CGainsWorks/emb-drone-flight-stack/hardware/flight-controller/outputs/bom/FCSTMV1.05-10.19.csv

Id | Designator | Footprint | Quantity | Designation | Supplier and ref
1 | J327,J376,J94,J308 | PinSocket_1x04_P2.54mm_Vertical | 4 | LED
2 | J323,J349,J403,J160,J342,J21,J150,J101,J12,J237,J269,J223,J367,J180,J25,J106,J263,J26,J381,J266,J174,J257,J314,J225,J3,J139,J326,J68,J324,J400,J14,J300,J176,J7,J255,J105,J243,J8,J201,J274,J186,J230,J224,J214,J347,J397,J188,J198,J15,J9,J154,J231,J111,J387,J153,J50,J187,J227,J241,J64,J185,J279,J220,J304,J303,J271,J70,J268,J194,J384,J200,J396,J287,J90,J368,J338,J260,J401,J244,J193,J77,J182,J27,J371,J96,J399,J358,J1,J305,J280,J407,J219,J217,J46,J259,J319,J147,J45,J295,J351,J317,J245,J28,J286,J377,J4,J183,J306,J181,J379,J242,J216,J146,J354,J143,J270,J328,J302,J61,J20,J49,J10,J199,J334,J141,J256,J318,J402,J123,J374,J209,J252,J212,J340,J51,J316,J385,J226,J285,J299,J100,J69,J79,J213,J404,J11,J73,J273,J85,J228,J177,J53,J267,J57,J262,J386,J32,J284,J236,J298,J309,J394,J184,J405,J86,J151,J54,J75,J159,J76,J83 | PinSocket_1x01_P2.54mm_Vertical | 171 | Conn_01x01_Pin
3 | J239,J251,J17,J232,J233,J282,J42,J294,J16,J189,J196,J208,J276,J275,J190,J23 | PinHeader_1x02_P2.54mm_Vertical | 16 | Conn_01x02_Pin
4 | R272,R299,R279,R34,R293,R245,R33,R298,R37,R283,R260,R40,R265,R270,R32,R39,R295,R266,R99,R280,R38,R247,R31,R93,R267,R276,R273,R244,R290,R63,R126,R128,R131,R119,R62,R112,R127,R121 | R_1206_3216Metric_Pad1.30x1.75mm_HandSolder | 38 | 0 ohm, 1206
5 | J393,J357,J331,J366,J31,J157,J155,J30,J156,J56,J112,J272,J59,J158,J80,J390,J313,J395,J135,J55,J246,J361,J203,J204,J332,J312,J365,J389,J110,J36,J356,J35,J128,J229,J149,J165,J173,J144,J152,J163,J172,J78 | PinSocket_1x02_P2.54mm_Vertical | 42 | Conn_01x02_Pin
6 | J248,J131,J211,J277,J215,J322,J19,J142,J87,J48,J47,J253,J234,J398,J336,J39,J372,J291,J192,J191,J210,J88,J297,J89,J383,J301,J337,J52,J409,J258,J254,J124,J345,J74,J166,J296,J205,J278,J18,J58,J235,J164,J130,J81 | PinSocket_1x03_P2.54mm_Vertical | 44 | Conn_01x03_Pin
7 | IC15,IC12 | QFP50P900X900X120-48N | 2 | ATMEGA4809-AF
8 | L16 | L_0603_1608Metric_Pad1.05x0.95mm_HandSolder | 1 | 22nH, 0603
9 | R294,R222,R221,R87,R90,R220,R81,R223,R88,R89 | R_1206_3216Metric_Pad1.30x1.75mm_HandSolder | 10 | 100 ohm, 1206
10 | C168,C171,C192,C210,C22,C193,C176,C19,C16,C172,C317,C197,C235,C189,C218,C10,C14,C213,C214,C13,C222,C244,C25,C9,C188,C35,C167,C66,C53,C50,C209,C39 | C_1206_3216Metric_Pad1.33x1.80mm_HandSolder | 32 | 100nF, 1206
11 | C256,C322,C131,C281,C114,C103,C113,C126,C135,C254,C133,C134,C253,C236,C266,C230,C132,C274,C237,C259,C277,C124,C128,C115,C112,C262,C224,C129,C267,C238,C280,C122,C261,C119,C271,C275,C226,C123,C273,C102,C278,C265,C120,C116,C227,C125,C231,C130,C228,C239,C225,C154,C156,C75,C152,C138,C144,C72,C155,C73,C136 | C_1206_3216Metric_Pad1.33x1.80mm_HandSolder | 61 | 0.1uF, 1206
12 | U10,U12,U11,U1 | LQFP-48_7x7mm_P0.5mm | 4 | STM32F051C8Tx
13 | R172,R26,R157,R13,R16,R209,R201,R146,R180,R175,R159,R183,R211,R24,R149,R198,R206,R208,R154,R23,R21,R185,R182,R156,R54 | R_1206_3216Metric_Pad1.30x1.75mm_HandSolder | 25 | 10k Ohm, 50V, 1206
14 | C283,C282 | C_1206_3216Metric_Pad1.33x1.80mm_HandSolder | 2 | 33 pF, 1206
15 | C279,C272,C223,C106,C303,C81,C263,C298,C276,C305,C229 | C_1206_3216Metric_Pad1.33x1.80mm_HandSolder | 11 | 4.7uF, 1206
16 | R147,R181,R22,R25,R184,R158,R173,R210,R207,R155,R14,R199 | R_1206_3216Metric_Pad1.30x1.75mm_HandSolder | 12 | 1k Ohm, 50V, 1206
17 | J24,J129,J333,J127,J341,J283,J350,J102,J364,J136,J335,J240,J197,J145,J137 | PinSocket_1x04_P2.54mm_Vertical | 15 | Conn_01x04_Pin
18 | INLA4,INLA3,INLA2,INLA1 | DRV8300DRGER- VQFN-24_L4.0-W4.0-P0.50-BL-EP2.5 | 4 | DRV8300DRGER
19 | C295,C284,C257,C302,C296,C319,C307,C293,C297,C268,C270 | C_1206_3216Metric_Pad1.33x1.80mm_HandSolder | 11 | 1 uF, 1206
20 | J307,J22,J388,J292,J249,J40,J238,J206,J348,J310,J378,J339,J195,J116,J281,J375 | PinSocket_1x05_P2.54mm_Vertical | 16 | Conn_01x05_Pin
21 | C198,C179,C178,C220,C200,C177,C26,C199,C28,C23,C221,C219 | C_1206_3216Metric_Pad1.33x1.80mm_HandSolder | 12 | 1uF, 50V, 1206
22 | R262,R243,R256,R254,R236,R261,R219,R289,R264,R218,R255,R216,R217,R257,R242,R274,R259,R288,R263 | R_1206_3216Metric_Pad1.30x1.75mm_HandSolder | 19 | 1k ohm, 1206
23 | J363,J118 | PinSocket_1x09_P2.54mm_Vertical | 2 | Conn_01x09_Pin
24 | C82 | C_1206_3216Metric_Pad1.33x1.80mm_HandSolder | 1 | 6.2pF, 1206
25 | D18,D6 | LED_0603_1608Metric_Pad1.05x0.95mm_HandSolder | 2 | APT1608QBC/G
26 | R98 | R_1206_3216Metric_Pad1.30x1.75mm_HandSolder | 1 | 27 ohm, 1206
27 | J132,J121,J133 | PinHeader_1x08_P2.54mm_Vertical | 3 | Conn_01x08_Pin
28 | R148,R200,R27,R249,R174,R250,R212,R15,R106,R167,R10,R143,R169,R105,R193,R141,R61,R195,R116,R8,R58 | R_1206_3216Metric_Pad1.30x1.75mm_HandSolder | 21 | 10k Ohm, 1206
29 | R101,R102 | R_1206_3216Metric_Pad1.30x1.75mm_HandSolder | 2 | 2 ohm, 1206
30 | R237,R239,R95,R240,R238,R97,R82 | R_1206_3216Metric_Pad1.30x1.75mm_HandSolder | 7 | 100k ohm, 1206
31 | J72,J344,J329,J119,J120,J97,J289,J29,J34,J107,J38,J360,J290,J392,J67,J247,J353,J391,J222,J66,J2,J63,J65,J162,J6,J134,J5,J218,J161,J352,J178,J95,J179,J60,J103,J91,J261,J355,J13,J104,J265,J369,J140,J175,J221,J264,J62 | SolderWirePad_1x01_SMD_5x10mm | 47 | Conn_01x01_Pin
32 | C95 | C_1206_3216Metric_Pad1.33x1.80mm_HandSolder | 1 | KGF31AR73A103KU
33 | R120,R122,R111 | R_1206_3216Metric_Pad1.30x1.75mm_HandSolder | 3 | RNCE1206BTE1K00
34 | C250,C258 | C_1206_3216Metric_Pad1.33x1.80mm_HandSolder | 2 | 22nF, 1206
35 | C195,C216,C232,C287,C174,C17,C233,C29,C31 | C_1206_3216Metric_Pad1.33x1.80mm_HandSolder | 9 | 10nF, 1206
36 | J408 | AMASS_XT30PW-M | 1 | XT30PW-M
37 | SW2,SW1 | SW-TH_RKJXK1210002 | 2 | RKJXK1210002
38 | C97,C90,C99,C91 | C_1206_3216Metric_Pad1.33x1.80mm_HandSolder | 4 | KGM31HR71E105KU
39 | R278,R68,R75 | R_1206_3216Metric_Pad1.30x1.75mm_HandSolder | 3 | 75 ohm, 1206
40 | Q31,Q32,Q30,Q34,Q35 | INFINEON_SOT343 | 5 | BFP520H6327XTSA1
41 | R92,R91 | R_1206_3216Metric_Pad1.30x1.75mm_HandSolder | 2 | 4.7k ohm, 1206
42 | J359,J202,J293,J33,J41,J315,J346,J250,J126,J207 | PinSocket_1x06_P2.54mm_Vertical | 10 | Conn_01x06_Pin
43 | R203,R151,R20,R179,R177,R18,R205,R153 | R_1206_3216Metric_Pad1.30x1.75mm_HandSolder | 8 | 0 Ohm, 1206
44 | R271,R277 | R_1206_3216Metric_Pad1.30x1.75mm_HandSolder | 2 | 200 ohm, 1206
45 | J311,J43,J37,J92,J320,J167,J330,J343,J168,J171,J169,J170 | SolderWirePad_1x01_SMD_1x2mm | 12 | Conn_01x01_Pin
46 | FL4 | BFCN5750 | 1 | BFCN-5750+
47 | R28,R30,R109,R74,R113 | R_1206_3216Metric_Pad1.30x1.75mm_HandSolder | 5 | 5.1k Ohm, 1206
48 | C110,C105,C108 | C_1206_3216Metric_Pad1.33x1.80mm_HandSolder | 3 | 220pF, 1206
49 | R292 | R_1206_3216Metric_Pad1.30x1.75mm_HandSolder | 1 | 10 ohm, 1206
50 | C169,C211,C111,C101,C306,C285,C286,C299,C288,C11,C190,C321 | C_1206_3216Metric_Pad1.33x1.80mm_HandSolder | 12 | 100pF, 1206
51 | R145,R12,R171,R197 | R_1206_3216Metric_Pad1.30x1.75mm_HandSolder | 4 | 1k Ohm, 1206
52 | C310,C294,C304,C300,C292 | C_1206_3216Metric_Pad1.33x1.80mm_HandSolder | 5 | 6pF, 1206
53 | J321,J117,J125,J362,J113,J114,J382,J325,J122,J84,J82 | PinSocket_1x07_P2.54mm_Vertical | 11 | Conn_01x07_Pin
54 | R17,R176,R202,R150,R55,R35,R231,R50,R56,R232,R48,R29 | R_1206_3216Metric_Pad1.30x1.75mm_HandSolder | 12 | 100k Ohm, 1206
55 | Y5,Y2,Y1 | FY0800027 | 3 | FY0800027
56 | R226,R227,R251,R96,R94,R225,R213,R224,R248 | R_1206_3216Metric_Pad1.30x1.75mm_HandSolder | 9 | 10k ohm, 1206
57 | C117,C127,C87,C89,C243,C65,C76,C158,C52,C141,C88,C153,C40,C24,C51 | C_1206_3216Metric_Pad1.33x1.80mm_HandSolder | 15 | 1uF, 1206
58 | R284,R67,R65,R66 | R_1206_3216Metric_Pad1.30x1.75mm_HandSolder | 4 | 22 ohm, 1206
59 | D1 | SMF5V0AE308 | 1 | SMF5V0A-E3-08
60 | D16,D15,D2,D17,D11,D12,D13,D10,D9,D14,D3,D4 | D_SOD-323F | 12 | PMEG4010CEJ,115
61 | C92 | C_1206_3216Metric_Pad1.33x1.80mm_HandSolder | 1 | KAF31ER71H474KL
62 | R125,R123 | R_1206_3216Metric_Pad1.30x1.75mm_HandSolder | 2 | TNPW120675R0BEEA
63 | R269 | R_1206_3216Metric_Pad1.30x1.75mm_HandSolder | 1 | 2.2k ohm, 1206
64 | C215,C191,C104,C194,C308,C196,C15,C21,C173,C313,C170,C107,C12,C217,C175,C212,C86,C157 | C_1206_3216Metric_Pad1.33x1.80mm_HandSolder | 18 | 10uF, 1206
65 | R234 | R_1206_3216Metric_Pad1.30x1.75mm_HandSolder | 1 | 18 ohm, 1206
66 | C264,C84,C260 | C_1206_3216Metric_Pad1.33x1.80mm_HandSolder | 3 | 20pF, 1206
67 | R258 | R_1206_3216Metric_Pad1.30x1.75mm_HandSolder | 1 | 12k ohm, 1206
68 | R11,R196,R170,R228,R144,R168,R194,R60,R142,R52,R9 | R_1206_3216Metric_Pad1.30x1.75mm_HandSolder | 11 | 100 Ohm, 1206
69 | Q8,Q9 | SOT-323_SC-70_Handsoldering | 2 | bc817w
70 | R296 | R_1206_3216Metric_Pad1.30x1.75mm_HandSolder | 1 | 200k ohm, 1206
71 | PS5 | SOT65P210X110-5N | 1 | TPS61169DCKR
72 | C289,C290 | C_1206_3216Metric_Pad1.33x1.80mm_HandSolder | 2 | 6.8pF, 1206
73 | R72 | R_1206_3216Metric_Pad1.30x1.75mm_HandSolder | 1 | 510k ohm, 1206
74 | C80,C312 | C_1206_3216Metric_Pad1.33x1.80mm_HandSolder | 2 | 33pF, 1206
75 | R103,R104,R132,R133 | R_1206_3216Metric_Pad1.30x1.75mm_HandSolder | 4 | 2.7k Ohms, 1206
76 | R86 | R_1206_3216Metric_Pad1.30x1.75mm_HandSolder | 1 | CRT1206-FX-4702ELF
77 | L15 | L_0603_1608Metric_Pad1.05x0.95mm_HandSolder | 1 | 10nH, 0603
78 | J373 | PinSocket_1x30_P2.54mm_Vertical | 1 | Conn_01x30_Pin
79 | C139,C145,C146,C143,C149,C151,C140,C137,C78,C77 | C_1206_3216Metric_Pad1.33x1.80mm_HandSolder | 10 | KAF31BR71H104KT
80 | C315,C323 | C_1206_3216Metric_Pad1.33x1.80mm_HandSolder | 2 | X F, 1206
81 | U13,U3 | FW520WFMT1 - SMD-4_L2.0-W1.6-FW520WFMT1 | 2 | FW520WFMT1
82 | R229 | R_1206_3216Metric_Pad1.30x1.75mm_HandSolder | 1 | 27k Ohm, 25V, 1206
83 | J99,J93,J108,J98,J148 | PinSocket_1x01_P2.00mm_Vertical | 5 | Conn_01x01_Pin
84 | Q33 | SOT96P237X111-3N | 1 | MMBTH81
85 | Q29,Q7,Q28 | SOT95P237X112-3N | 3 | IRLML0030TRPBF
86 | J109,J406 | U.FL-R-SMT-1_10_ | 2 | U.FL-R-SMT-1_10_
87 | IC1 | DQA_R-PUSON-N10_ | 1 | TPD4EUSB30DQAR
88 | D8,D20 | LED_0603_1608Metric_Pad1.05x0.95mm_HandSolder | 2 | APT1608SECK
89 | L13 | L_0603_1608Metric_Pad1.05x0.95mm_HandSolder | 1 | 33nH, 0603
90 | C251 | C_1206_3216Metric_Pad1.33x1.80mm_HandSolder | 1 | X uF, 1206
91 | R241 | R_1206_3216Metric_Pad1.30x1.75mm_HandSolder | 1 | 10.2 ohm, 1206
92 | C311,C316,C328,C100,C109,C41,C54 | C_1206_3216Metric_Pad1.33x1.80mm_HandSolder | 7 | 10pF, 1206
93 | C234,C33 | C_1206_3216Metric_Pad1.33x1.80mm_HandSolder | 2 | KAF31ER71H474KU
94 | R178,R204,R152,R19 | R_1206_3216Metric_Pad1.30x1.75mm_HandSolder | 4 | 0 Ohm, 12060 Ohm, 1206
95 | U14 | TQFP-64_7x7mm_P0.4mm | 1 | ~
96 | U2 | ESP32C3MINI1H4X | 1 | ESP32-C3-MINI-1-H4X
97 | C93,C96 | C_1206_3216Metric_Pad1.33x1.80mm_HandSolder | 2 | 15pF, 1206
98 | IC11 | ESP32WROOM32EH4 | 1 | ESP32-WROOM-32E-H4
99 | J288,J370 | PinSocket_1x12_P2.54mm_Vertical | 2 | Conn_01x12_Pin
100 | J44,J138 | USB4730GFAKIT | 2 | USB4730-GF-A-KIT
101 | FL1 | 0805USBN121MRC | 1 | 0805USBN-271MRC
102 | R83 | R_1206_3216Metric_Pad1.30x1.75mm_HandSolder | 1 | 3.3k Ohm, 1206
103 | R69,R71,R285 | R_1206_3216Metric_Pad1.30x1.75mm_HandSolder | 3 | 1.2k ohm, 1206
104 | S4,S5,S2,S3,S1 | PTS647SK70SMTR2NLFS | 5 | PTS647SK70SMTR2N_LFS
105 | R246 | R_1206_3216Metric_Pad1.30x1.75mm_HandSolder | 1 | 1M ohm, 1206
106 | C118,C121,C147,C85 | C_1206_3216Metric_Pad1.33x1.80mm_HandSolder | 4 | 2.2uF, 1206
107 | R230 | R_1206_3216Metric_Pad1.30x1.75mm_HandSolder | 1 | 10k Ohm, 25V, 1206
108 | LS2,LS1 | CMT8504100SMTTR | 2 | CMT-8504-100-SMT-TR
109 | C252 | C_1206_3216Metric_Pad1.33x1.80mm_HandSolder | 1 | 4.7 uF, 1206
110 | R268 | R_1206_3216Metric_Pad1.30x1.75mm_HandSolder | 1 | 390k ohm, 1206
111 | U17 | TA0555A | 1 | ~
112 | ANT2 | SAMM10Q00B | 1 | SAM-M10Q-00B
113 | U16 | RTC6715 - TQFN-48_L7.0-W7.0-P0.50-BL-EP5.5 | 1 | RTC6715
114 | L17 | L_0603_1608Metric_Pad1.05x0.95mm_HandSolder | 1 | 27nH, 0603
115 | Y3,Y4 | ABM810000MHZ12D2W | 2 | ABM8-27.000MHZ-B2-T
116 | R291,R282,R287,R281 | R_1206_3216Metric_Pad1.30x1.75mm_HandSolder | 4 | X ohm, 1206
117 | R84 | R_1206_3216Metric_Pad1.30x1.75mm_HandSolder | 1 | RT1206BRB07100KL
118 | L20,L19 | L_0603_1608Metric_Pad1.05x0.95mm_HandSolder | 2 | 12nH, 0603
119 | IC6 | QPA9501TR13 | 1 | QPA9501TR13
120 | C150,C148 | C_1206_3216Metric_Pad1.33x1.80mm_HandSolder | 2 | CAA572X7R1H476M670LJ
121 | D22 | DIOM5127X229N | 1 | SS16-E3_61T
122 | R100 | R_1206_3216Metric_Pad1.30x1.75mm_HandSolder | 1 | 27.4k ohm, 1206
123 | R297 | R_1206_3216Metric_Pad1.30x1.75mm_HandSolder | 1 | 33k ohm, 1206
124 | R73 | R_1206_3216Metric_Pad1.30x1.75mm_HandSolder | 1 | 560k ohm, 1206
125 | L14 | SRN2010BTA180M | 1 | SRN2010BTA-180M
126 | U15,U6 | SOIC127P790X216-8N | 2 | W25Q128JVSIQ
127 | R42,R41,R117,R118 | R_1206_3216Metric_Pad1.30x1.75mm_HandSolder | 4 | 22 Ohm, 1206
128 | R76 | R_1206_3216Metric_Pad1.30x1.75mm_HandSolder | 1 | 15k Ohm, 1206
129 | C291,C142 | C_1206_3216Metric_Pad1.33x1.80mm_HandSolder | 2 | 0.01uF, 1206
130 | R252,R215,R253,R214 | R_1206_3216Metric_Pad1.30x1.75mm_HandSolder | 4 | 2.7k ohm, 1206
131 | U9 | NINA-B416-01B - LGA-60_L15.0-W10.0-NINA-B406-00B | 1 | NINA-B416-01B
132 | C329,C325 | C_1206_3216Metric_Pad1.33x1.80mm_HandSolder | 2 | 1nF, 1206
133 | U5 | LQFP-144_20x20mm_P0.5mm | 1 | STM32F405ZGTx
134 | R85 | R_1206_3216Metric_Pad1.30x1.75mm_HandSolder | 1 | ERA-8AEB510V
135 | IC16 | SON50P150X150X50-7N-D | 1 | SKY65404-31
136 | U4 | RTC6705 - VFQFN-40_L6.0-W6.0-P0.50-TL-EP4.7-1 | 1 | RTC6705
137 | L12 | LSEUC2520KKT4R7M | 1 | LSEUC2520KKT4R7M
138 | J115 | PinSocket_1x11_P2.54mm_Vertical | 1 | Conn_01x11_Pin
139 | C242,C64 | C_1206_3216Metric_Pad1.33x1.80mm_HandSolder | 2 | 0.01uF, Min. 50V, 1206
140 | C326 | C_1206_3216Metric_Pad1.33x1.80mm_HandSolder | 1 | 1n F, 1206
141 | C327 | C_1206_3216Metric_Pad1.33x1.80mm_HandSolder | 1 | 4.7pF, 1206
142 | BZ1 | Buzzer_12x9.5RM7.6 | 1 | Haptics
143 | C269 | C_1206_3216Metric_Pad1.33x1.80mm_HandSolder | 1 | 22pF, 1206
144 | C309,C301 | C_1206_3216Metric_Pad1.33x1.80mm_HandSolder | 2 | 470pF, 1206
145 | J71 | AMASS_XT60-M | 1 | XT60-M
146 | C314 | C_1206_3216Metric_Pad1.33x1.80mm_HandSolder | 1 | 47pF, 1206
147 | R70 | R_1206_3216Metric_Pad1.30x1.75mm_HandSolder | 1 | 270 ohm, 1206
148 | C98,C94,C79 | C_1206_3216Metric_Pad1.33x1.80mm_HandSolder | 3 | CL31Y475KCK6NWE
149 | IC13,IC2 | QFN50P400X400X100-25N-D | 2 | SX1280IMLTRT
150 | C255,C46,C37,C47,C38,C36,C45 | C_1206_3216Metric_Pad1.33x1.80mm_HandSolder | 7 | 4.7uF, 50V, 1206
151 | C318 | C_1206_3216Metric_Pad1.33x1.80mm_HandSolder | 1 | 12pF, 1206
152 | L18 | SRN5040TAR60MP | 1 | SRN5040TA-R60MP
153 | C324 | C_1812_4532Metric_Pad1.57x3.40mm_HandSolder | 1 | 18125C484KAT2A
154 | R275 | R_1206_3216Metric_Pad1.30x1.75mm_HandSolder | 1 | 430k ohm, 1206
155 | D7,D19 | LED_0603_1608Metric_Pad1.05x0.95mm_HandSolder | 2 | APT1608ZGC
156 | U8 | TSSOP-28_L9.7-W4.4-P0.65-LS6.4-BL-EP-2 | 1 | AT7456E
157 | ANT3,ANT1 | 479480001 | 2 | 47948-0001
158 | R235 | R_1206_3216Metric_Pad1.30x1.75mm_HandSolder | 1 | 56 ohm, 1206
159 | C320 | C_1206_3216Metric_Pad1.33x1.80mm_HandSolder | 1 | 39pF, 1206
160 | R286,R78 | R_1206_3216Metric_Pad1.30x1.75mm_HandSolder | 2 | 470 ohm, 1206
161 | FL3,FL2 | 2450FM07D0034001T | 2 | 2450FM07D0034001T
162 | Q17,Q23,Q13,Q16,Q18,Q19,Q15,Q27,Q12,Q26,Q22,Q3,Q10,Q21,Q25,Q20,Q1,Q6,Q14,Q4,Q2,Q5,Q11,Q24 | BUK7Y1255B115 | 24 | PSMN1R4-40YLDX
163 | R110,R124,R129,R108 | R_1206_3216Metric_Pad1.30x1.75mm_HandSolder | 4 | 4.7k Ohm, 1206
164 | C164,C2,C186,C184,C161,C165,C7,C162,C203,C163,C5,C201,C159,C160,C3,C183,C202,C205,C206,C180,C182,C185,C207,C204,C4,C181,C6,C1 | CAPC6050X690N | 28 | 47uF, 50V, 2420
165 | R134,R3,R166,R140,R186,R192,R139,R161,R136,R6,R164,R138,R190,R5,R2,R191,R7,R1,R162,R135,R160,R165,R187,R188 | R_1206_3216Metric_Pad1.30x1.75mm_HandSolder | 24 | 20 Ohm, 50V, 1206
166 | L2,L5 | L_1206_3216Metric_Pad1.42x1.75mm_HandSolder | 2 | BLM31SN500SH1L
167 | IC4,IC3 | QFN50P300X600X80-29N-D | 2 | LT8612IUDE#PBF
168 | C60,C44 | CAPPRD500W65D1000H2200 | 2 | 25V, 820uF, Low ESR, Through Hole
169 | D5,D21 | DIOM7959X262N | 2 | SMCJ33A
170 | L1,L11,L9 | XAL7030682MEC | 3 | XAL7030-682MEC
171 | L7,L6,L3,L4 | XAL7070472MEC | 4 | XAL7070-472MEC
172 | R4,R137,R163,R189 | R_2512_6332Metric_Pad1.40x3.35mm_HandSolder | 4 | 0.005Ohms, 2512, 5W, Current Sense
173 | C63,C49,C241,C20 | C_1206_3216Metric_Pad1.33x1.80mm_HandSolder | 4 | 220nF, 50V, 1206
174 | IC14 | SOT95P280X100-5N | 1 | ADPL40502AUJZ-1.2-R7
175 | C68,C247 | CAPPRD500W60D1250H2000 | 2 | 35V, 1000uF, Low ESR, Through Hole
176 | C74 | C_1206_3216Metric_Pad1.33x1.80mm_HandSolder | 1 | 560pF, 1206
177 | IC5 | QFN50P500X500X60-33N-D | 1 | STM32G431KBU6
178 | PS2,PS3,PS4,PS1 | SOIC127P600X170-9N | 4 | LMR33630ADDA
179 | C69,C32,C61,C71,C246,C27,C249,C67,C59,C30,C70,C248,C34,C245,C58,C57 | C_1206_3216Metric_Pad1.33x1.80mm_HandSolder | 16 | 22uF, 1206
180 | C62,C240,C18,C48 | C_1206_3216Metric_Pad1.33x1.80mm_HandSolder | 4 | 10uF, 50V, 1206
181 | R107,R114 | R_1206_3216Metric_Pad1.30x1.75mm_HandSolder | 2 | RNCE1206BTE10K0
182 | R43,R46 | R_1206_3216Metric_Pad1.30x1.75mm_HandSolder | 2 | 52.3k Ohm, 1206
183 | R53 | R_1206_3216Metric_Pad1.30x1.75mm_HandSolder | 1 | 100k Ohm, 50V, 1206
184 | C43,C55,C42,C56 | C_1206_3216Metric_Pad1.33x1.80mm_HandSolder | 4 | 47uF, 1206
185 | R59 | R_1206_3216Metric_Pad1.30x1.75mm_HandSolder | 1 | MCA1206MZ0000ZP500
186 | R130 | R_1206_3216Metric_Pad1.30x1.75mm_HandSolder | 1 | 10k Ohms, 1206
187 | C166,C208,C187,C8 | C_1206_3216Metric_Pad1.33x1.80mm_HandSolder | 4 | 2200 pF, 1206
188 | R47,R44 | R_1206_3216Metric_Pad1.30x1.75mm_HandSolder | 2 | 243k Ohm, 1206
189 | R115 | R_1206_3216Metric_Pad1.30x1.75mm_HandSolder | 1 | R
190 | IC9 | BMP390 | 1 | BMP390
191 | IC10 | MMC5983MA | 1 | MMC5983MA
192 | R49,R45 | R_1206_3216Metric_Pad1.30x1.75mm_HandSolder | 2 | 1M Ohm, 1206
193 | R79 | R_1206_3216Metric_Pad1.30x1.75mm_HandSolder | 1 | 51k ohm, 1206
194 | IC7 | SOP65P640X120-14N | 1 | TXS0104EPWR
195 | M2,M1,M3,M4 | SOIC127P600X175-8N | 4 | INA240A1D
196 | L10 | L_0603_1608Metric_Pad1.05x0.95mm_HandSolder | 1 | mpz1608s601ata00
197 | R77 | R_1206_3216Metric_Pad1.30x1.75mm_HandSolder | 1 | 20k ohm, 1206
198 | U7 | PQFN50P300X250X97-14N | 1 | ICM-42688-P
199 | R233,R36,R57 | R_1206_3216Metric_Pad1.30x1.75mm_HandSolder | 3 | 43.2k Ohm, 1206
200 | IC8 | SOT95P280X145-5N | 1 | TPS7A2033PDBVR
201 | J380 | 54132-4062_1 | 1 | 54132-4062
202 | R51 | R_1206_3216Metric_Pad1.30x1.75mm_HandSolder | 1 | 24.9k Ohm, 1206
203 | C83 | C_1206_3216Metric_Pad1.33x1.80mm_HandSolder | 1 | 330pF, 1206
204 | R64 | R_1206_3216Metric_Pad1.30x1.75mm_HandSolder | 1 | 75 Ohm, 1206
205 | L8 | XAL7030822MEC | 1 | XAL7030-822MEC
206 | R80 | R_1206_3216Metric_Pad1.30x1.75mm_HandSolder | 1 | 750 ohm, 1206
