CGainsWorks/emb-drone-flight-stack/test-results/sil/pitch_rate_step.png

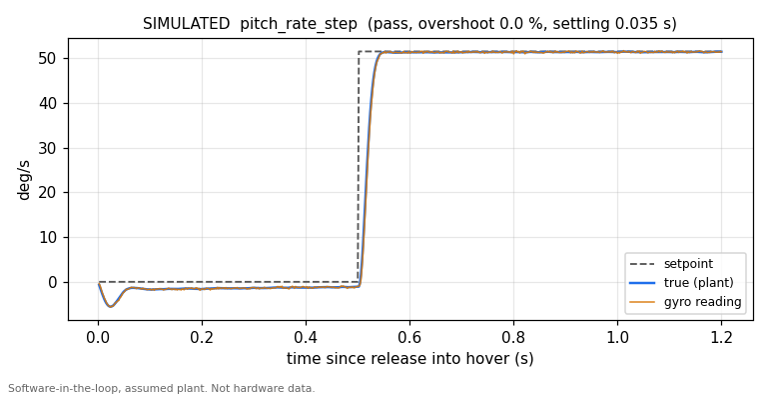
test-results/sil/pitch_rate_step.png
