CGainsWorks/emb-drone-flight-stack/test-results/sil/roll_rate_step.png

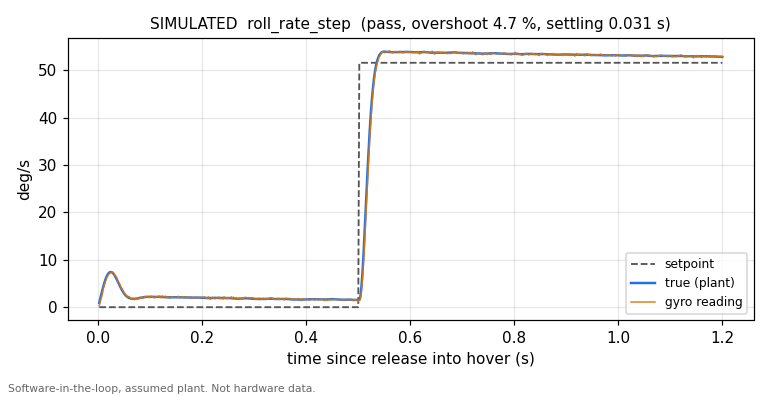
test-results/sil/roll_rate_step.png
