CGainsWorks/emb-drone-flight-stack/test-results/sil/yaw_rate_step.png

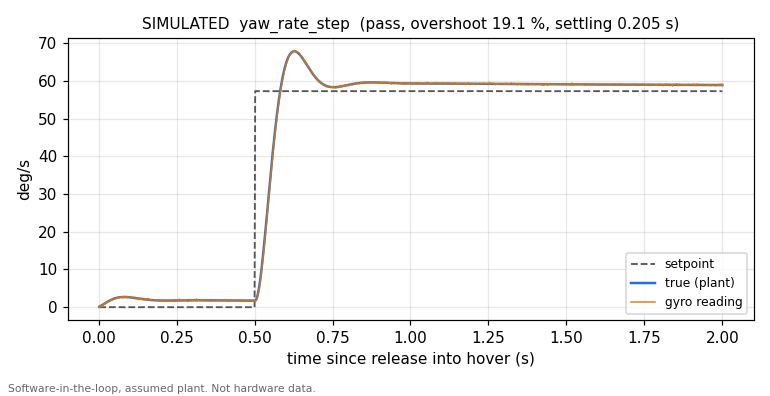
test-results/sil/yaw_rate_step.png
