CGainsWorks/emb-drone-flight-stack/hardware/esc/docs/ESCPart1.pdf

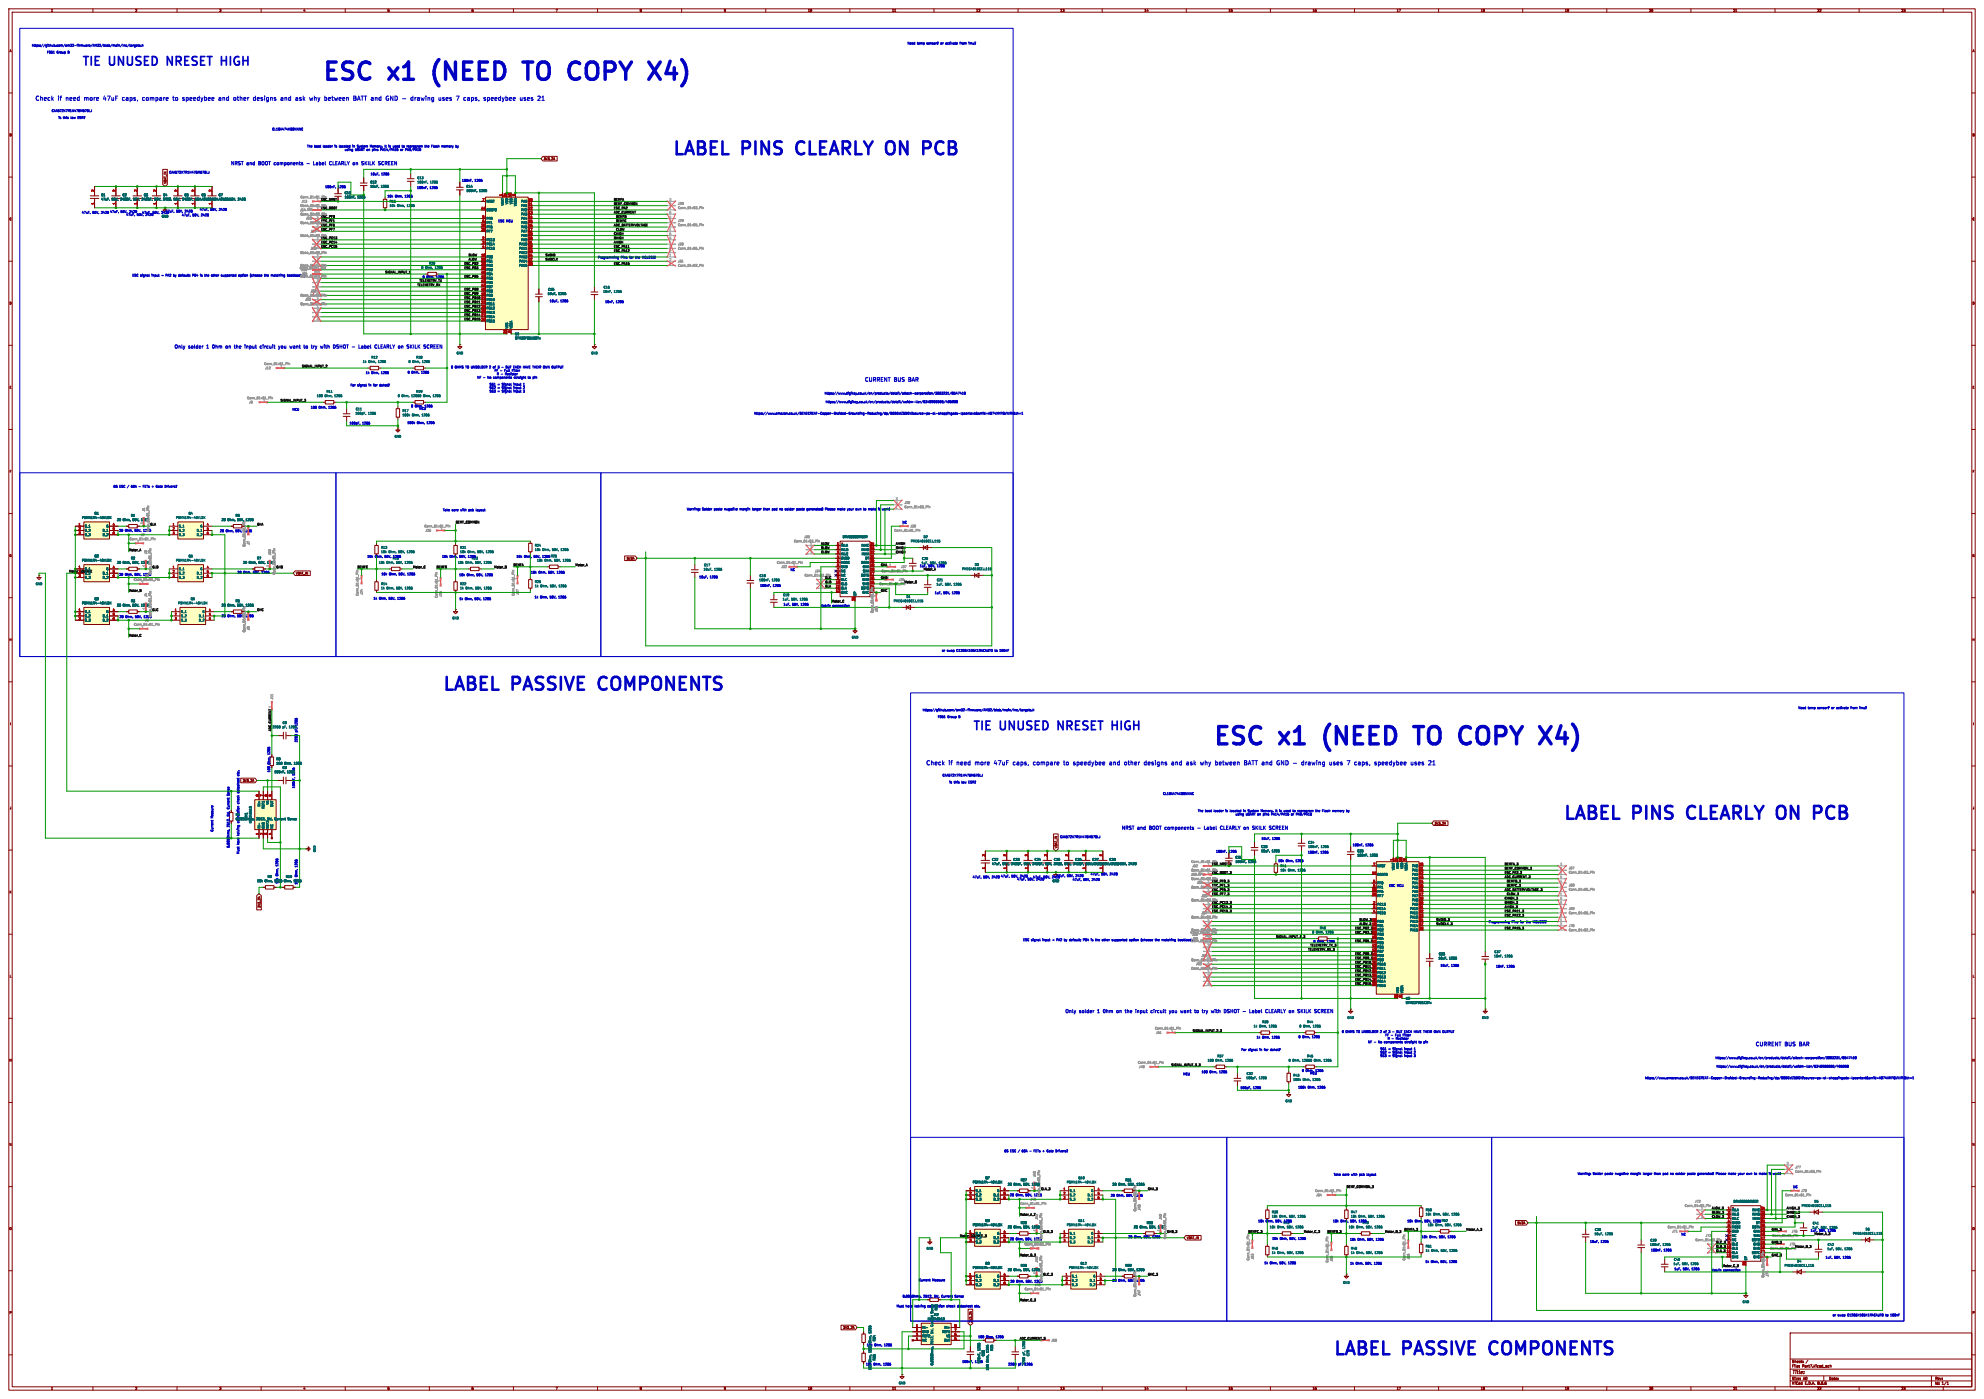
[picture p5: page 1]

https://github.com/am32-firmware/AM32/blob/main/Inc/targets.h

ESC x1 (NEED TO COPY X4)

Check if need more 47uF caps, compare to speedybee and other designs and ask why between BATT and GND - drawing uses 7 caps, speedybee uses 21

1 PA0 10 PA1 11 PA2 12 PA3 13 PA4 14 PA5 15 PA6 16 PA7 17 PB0 18 PB1 19 PC13 2 PB2 20 PB10 21 PB11 22 VSS 23 VDD 24 PB12 25 PB13 26 PB14 27 PB15 28 PA8 29 PC14 3 PA9 30 PA10 31 PA11 32 PA12 33 PA13 34 PF6 35 PF7 36 PA14 37 PA15 38 PB3 39 PC15 4 PB4 40 PB5 41 PB6 42 PB7 43 BOOT0 44 PB8 45 PB9 46 VDD 48 PF0 5 PF1 6 NRST 7 VSSA
U1STM32F051C8Tx VBAT

0 OHMS TO UNSOLDER 2 of 3 - BUT EACH HAVE THEIR OWN OUTPUT

For signal in for dshot?

https://www.digikey.co.uk/en/products/detail/altech-corporation/3803231/8547418

https://www.digikey.co.uk/en/products/detail/weidm-ller/0348900000/496908

https://www.amazon.co.uk/BENECREAT-Copper-Braided-Grounding-Reducing/dp/B0BGWZ5DGV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

6S ESC / 60A - FETs + Gate Drivers?

Take care with pcb layout

https://github.com/am32-firmware/AM32/blob/main/Inc/targets.h F051 Group B

100nF, 1206 ESC x1 (NEED TO COPY X4)

is this low ESR?

0 Ohm, 1206 For signal in for dshot?

1k Ohm, 50V, 1206
Kelvin connection LABEL PASSIVE COMPONENTS

100nF, 1206 Must have kelving connection check datasheet etc. 100 Ohm, 1206
