CGainsWorks/emb-drone-flight-stack/hardware/flight-controller/docs/FC.pdf

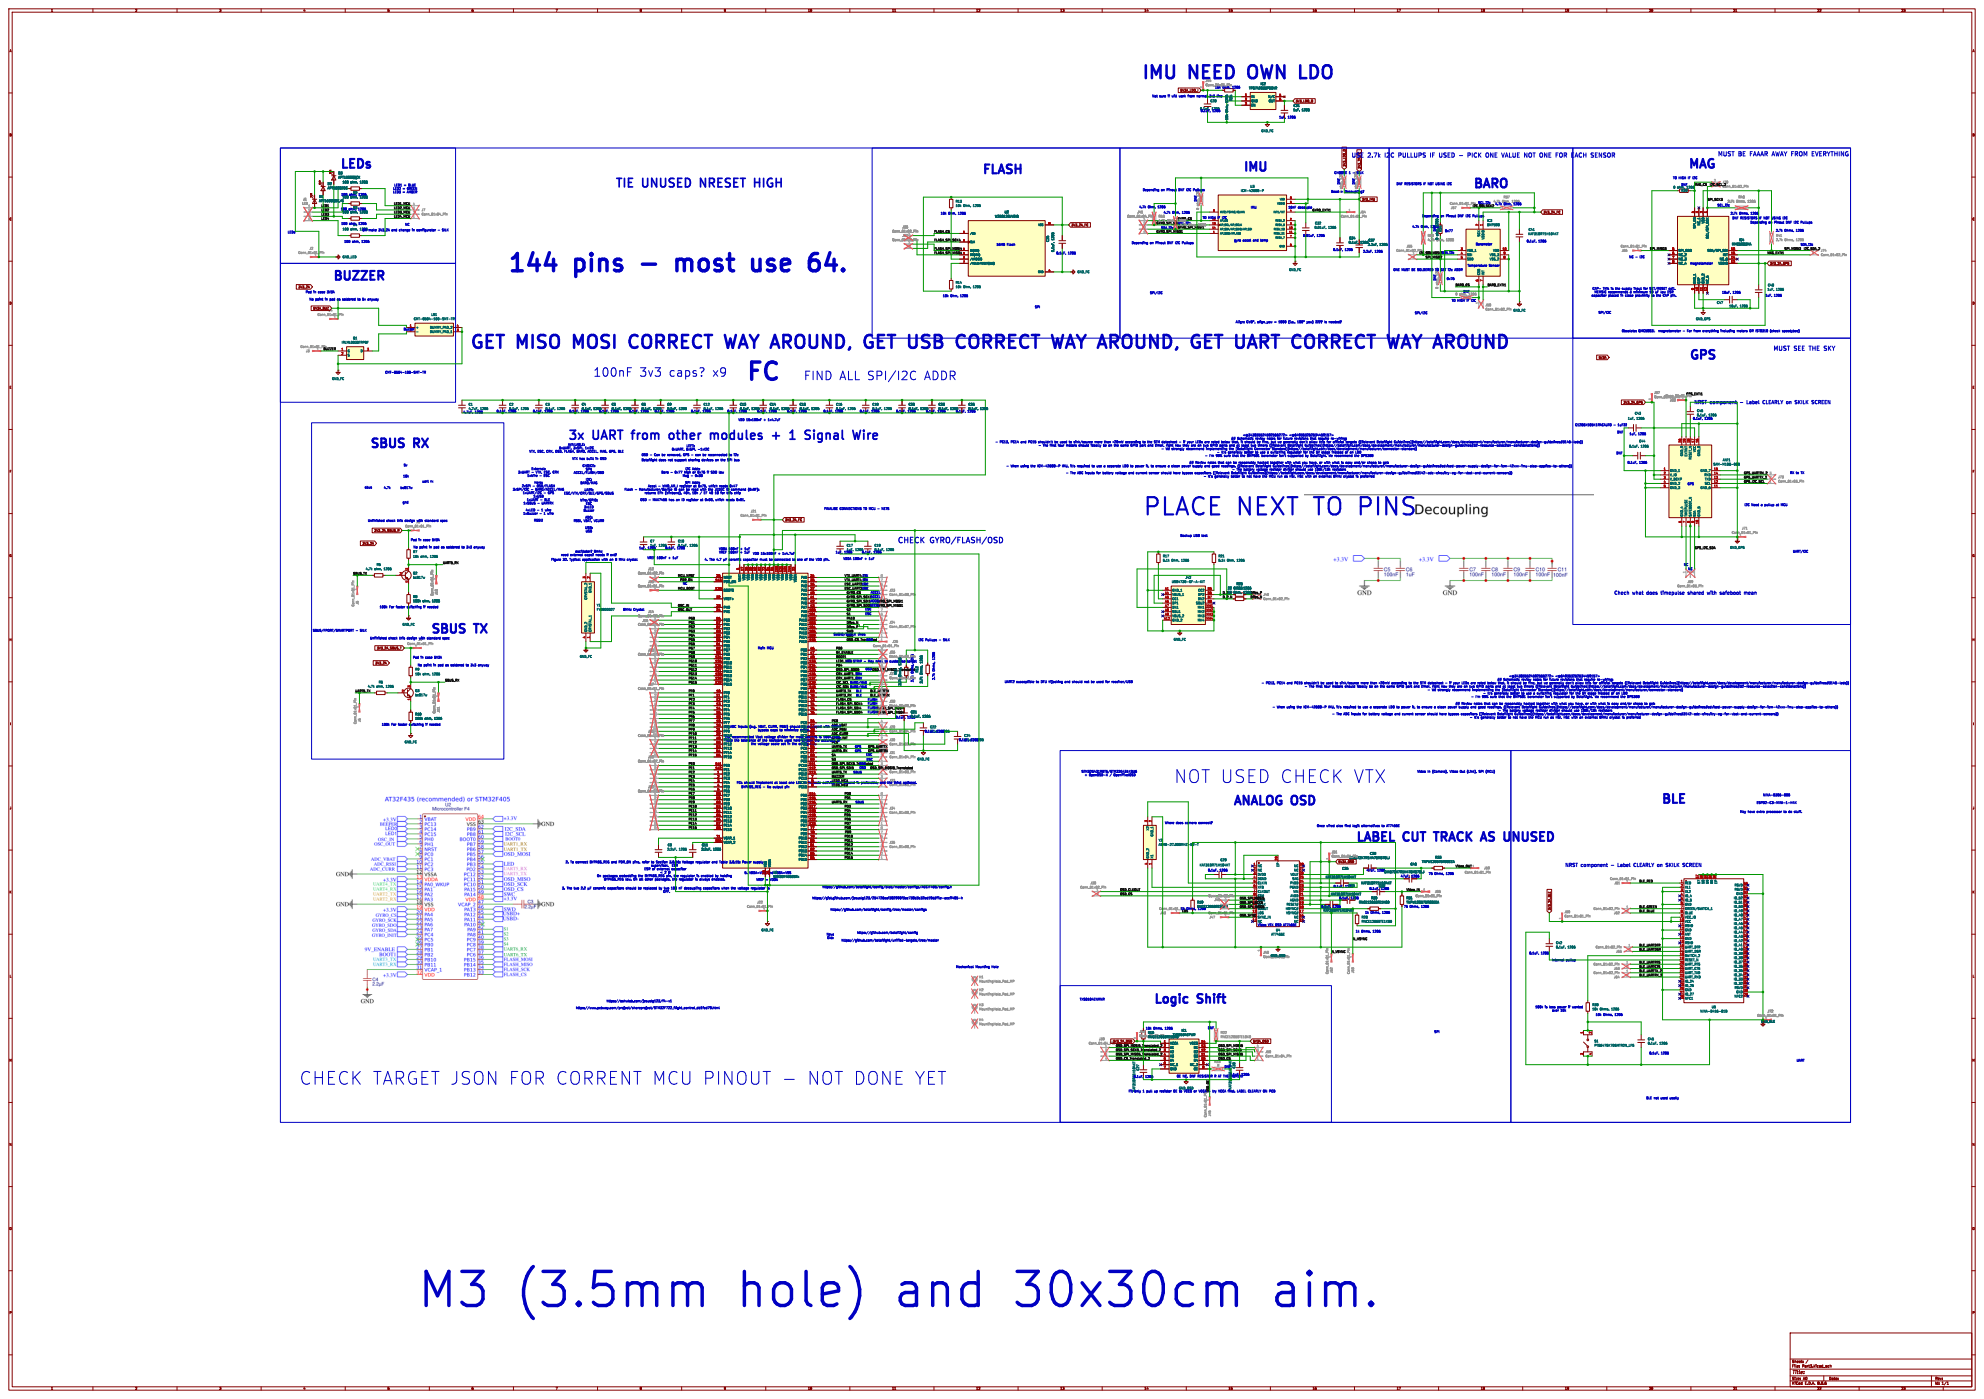
[picture p6: page 1]

10k Ohm, 1206 Not sure if will work from normal 3v3 line IMU NEED OWN LDO

3V3_IMU 3V3_LDO_O
USE 2.7k I2C PULLUPS IF USED - PICK ONE VALUE NOT ONE FOR EACH SENSOR

TIE UNUSED NRESET HIGH

0.1uF, 1206 DNF RESISTORS IF NOT USING I2C
SPI_SCK2 OSD_OE

2.7k Ohms, 1206
DNF RESISTORS IF NOT USING I2C

Depending on Pinout DNF I2C Pullups SPI/I2C
GPS DNF
4.7k Ohm, 1206 R34

2.7k Ohms, 1206 Depending on Pinout DNF I2C Pullups

gyro accel and temp

0.1uF, 1206 ACCEL ESC 144 pins - most use 64.

Align: þÿCW0°, align_yaw = 1800 (i.e., þÿ180° yaw) ???? Is needed?

VTX, ESC, CRX, OSD, FLASH, BARO, ACCEL, MAG, GPS, BLE

PLACE NEXT TO PINS

External: 3xUART - VTX, ESC, CRX

UART: ESC/VTX/CRX/BLE/GPS/SBUS Wire/GPIO: ESC

gnd Unfinished check this design with standard spec Pad in case 5V3A
100k ohm, 1206 R7
10k ohm, 1206

3xLED
Buzzer ADC: RSSI, VBAT, VCURR

I2C Need a pullup at MCU

1uF, 1206 FINALISE CONNECTIONS TO MCU - NETS

CHECK GYRO/FLASH/OSD

No point in pad as soldered to 3v3 anyway

No point in pad as soldered to 3v3 anyway SBUS TX

All ADC inputs (e.g. VBAT, CURR, RSSI) should be equipped with 100nF

the voltage scale set in the config file.

Where does camera connect? SBUS

LABEL CUT TRACK AS UNUSED

5. VDDA=VDD and VSSA=VSS

https://gist.github.com/jesuslg123/254726eaf382990f3ac738d3c32ed19d#file-accif405-h

https://github.com/betaflight/config/tree/master/configs

J43 Conn_01x01_Pin
1k Ohms, 1206 DNF Logic Shift

https://github.com/betaflight/config

100k is less power if wanted

https://www.pcbway.com/project/shareproject/STM32F722_flight_control_dd1fcd79.html

CHECK TARGET JSON FOR CORRENT MCU PINOUT - NOT DONE YET

OE NC, DNF RESISTOR R AT THE MOMENT

Fit only 1 pull up resistor OE to VCCB or VCCA - try VCCA first. LABEL CLEARLY ON PCB

BLE not used usally
