CGainsWorks/emb-drone-flight-stack/hardware/rf/docs/CRX.pdf

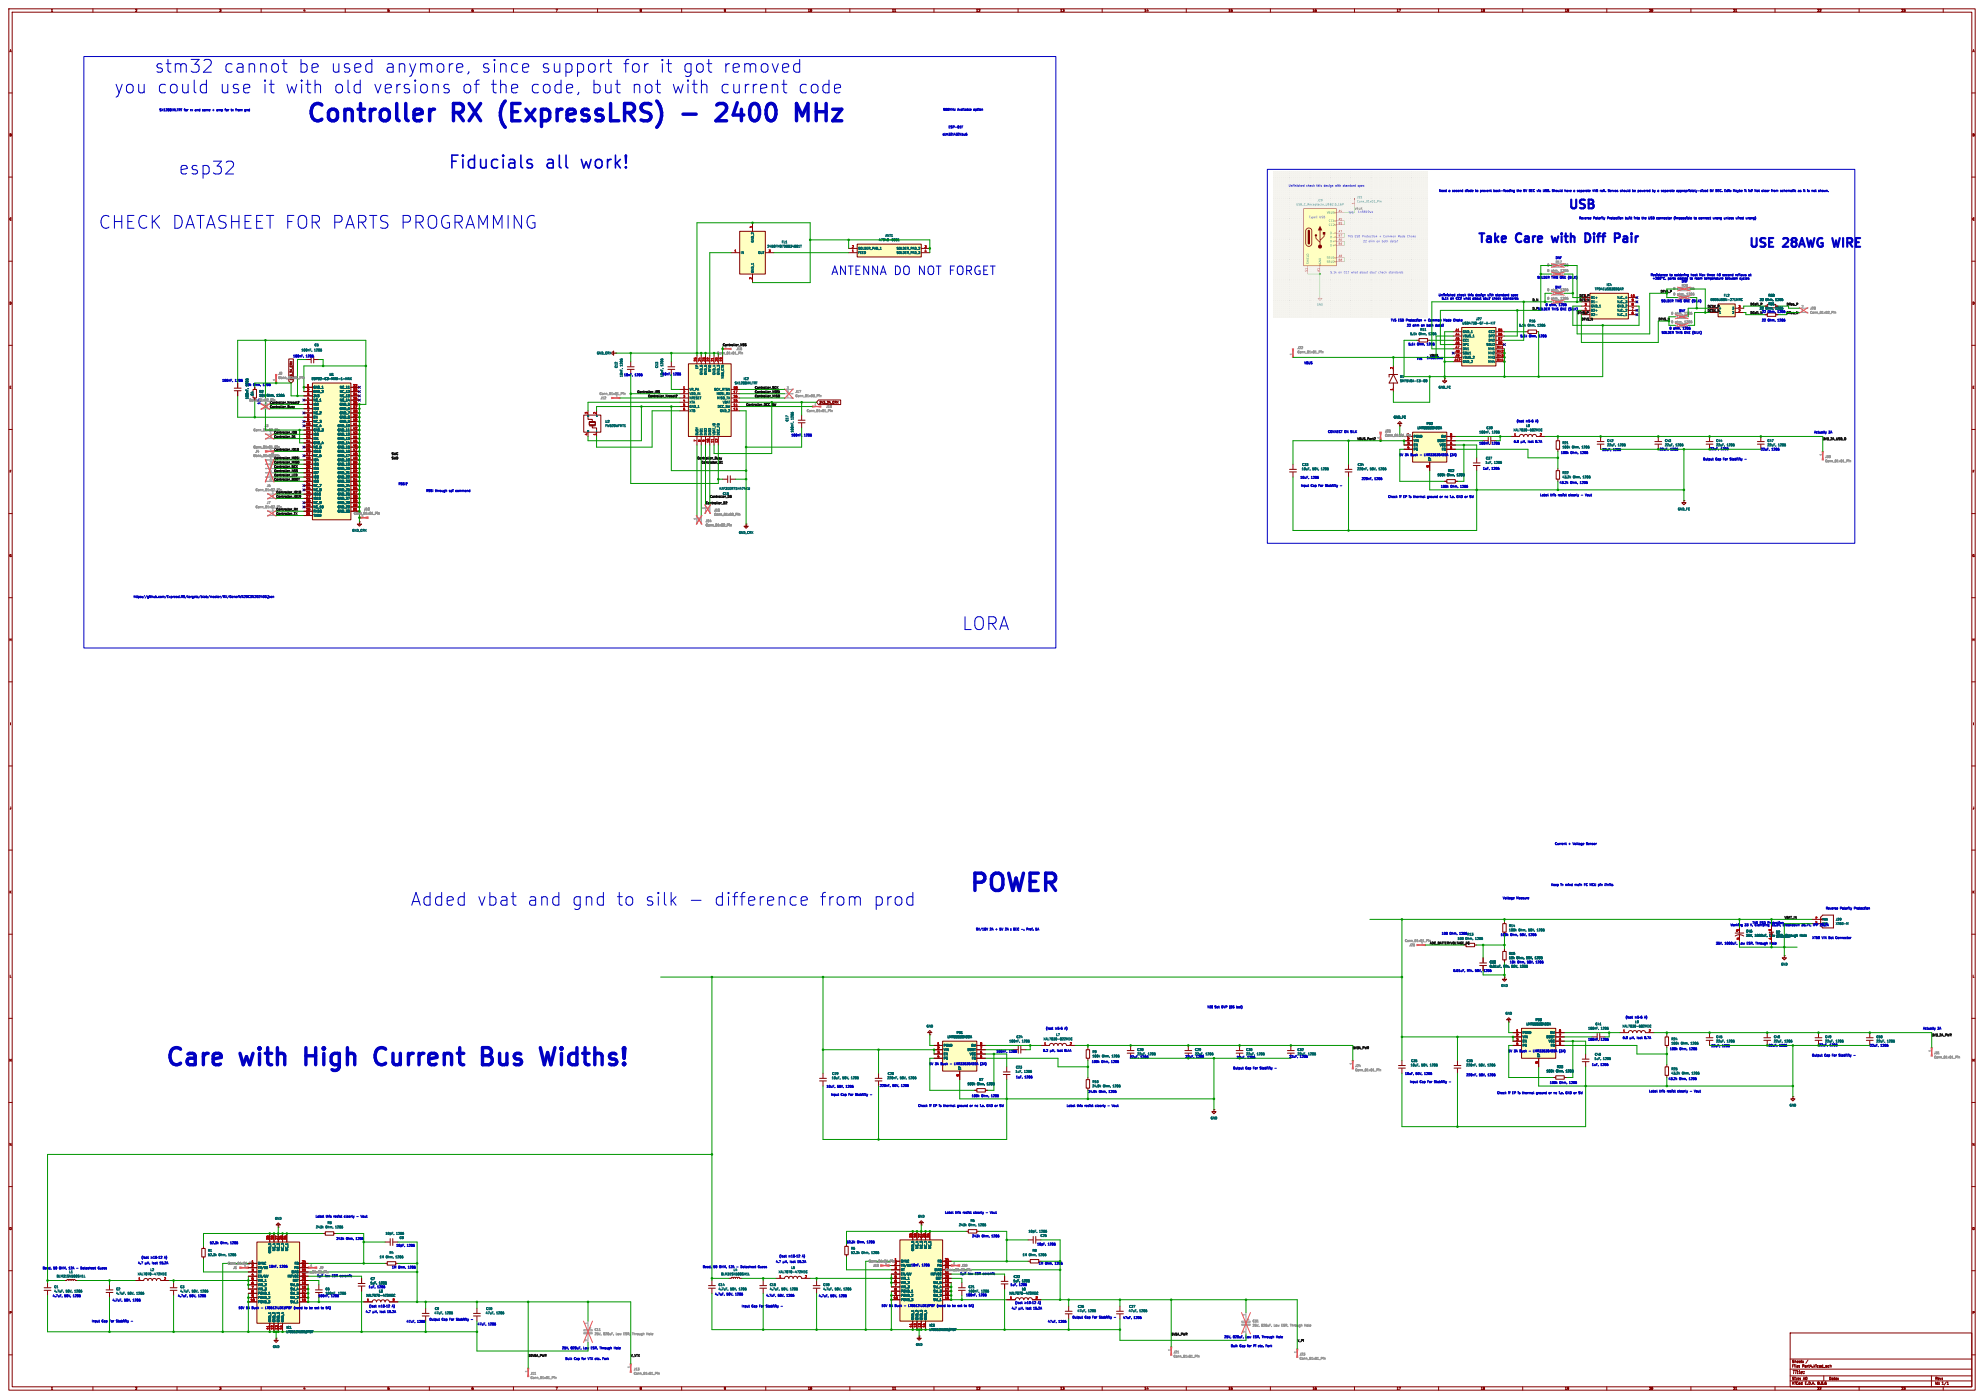
[picture p7: page 1]

stm32 cannot be used anymore, since support for it got removed
you could use it with old versions of the code, but not with current code

Controller RX (ExpressLRS) - 2400 MHz

SX1280IMLTRT for rx and same + amp for tx from gnd

CHECK DATASHEETFOR PARTS PROGRAMMING

Take Care with Diff Pair

FEED
ANTENNA DO NOT FORGET

SOLDER THIS ONE (SILK) DNF

Unfinished check this design with standard spec
5.1k on CC? what about sbu? check standards 5.1k Ohm, 1206

DNF SOLDER THIS ONE (SILK)

22 ohm on both data?

SOLDER THIS ONE (SILK)

25V, 820uF, Low ESR, Through Hole C17 100nF, 1206

(Isat þÿ"e5 6A) 6.8 þÿµH, Isat 8.7A
L8 XAL7030-682MEC

Check if EP is thermal ground or nc i.e. GND or SW

Label this resist clearly - Vout

https://github.com/ExpressLRS/targets/blob/master/RX/Generic%20C3%202400.json

Current + Voltage Sensor Keep in mind main FC MCU pin limits Voltage Measure

Label this resist clearly - Vout 6.8 þÿµH, Isat 8.7A

þÿ1¼Flow ESR ceramic Care with High Current Bus Widths!

5V 3A Buck - LMR33630ADDA (3A) Check if EP is thermal ground or nc i.e. GND or SW

(Isat þÿ"e10 12A) 4.7 þÿµH, Isat 15.2A

þÿ1¼Flow ESR ceramic

25V, 820uF, Low ESR, Through Hole

Bulk Cap for Pi etc. Fork
