CGainsWorks/emb-drone-flight-stack/hardware/rf/docs/CTX.pdf

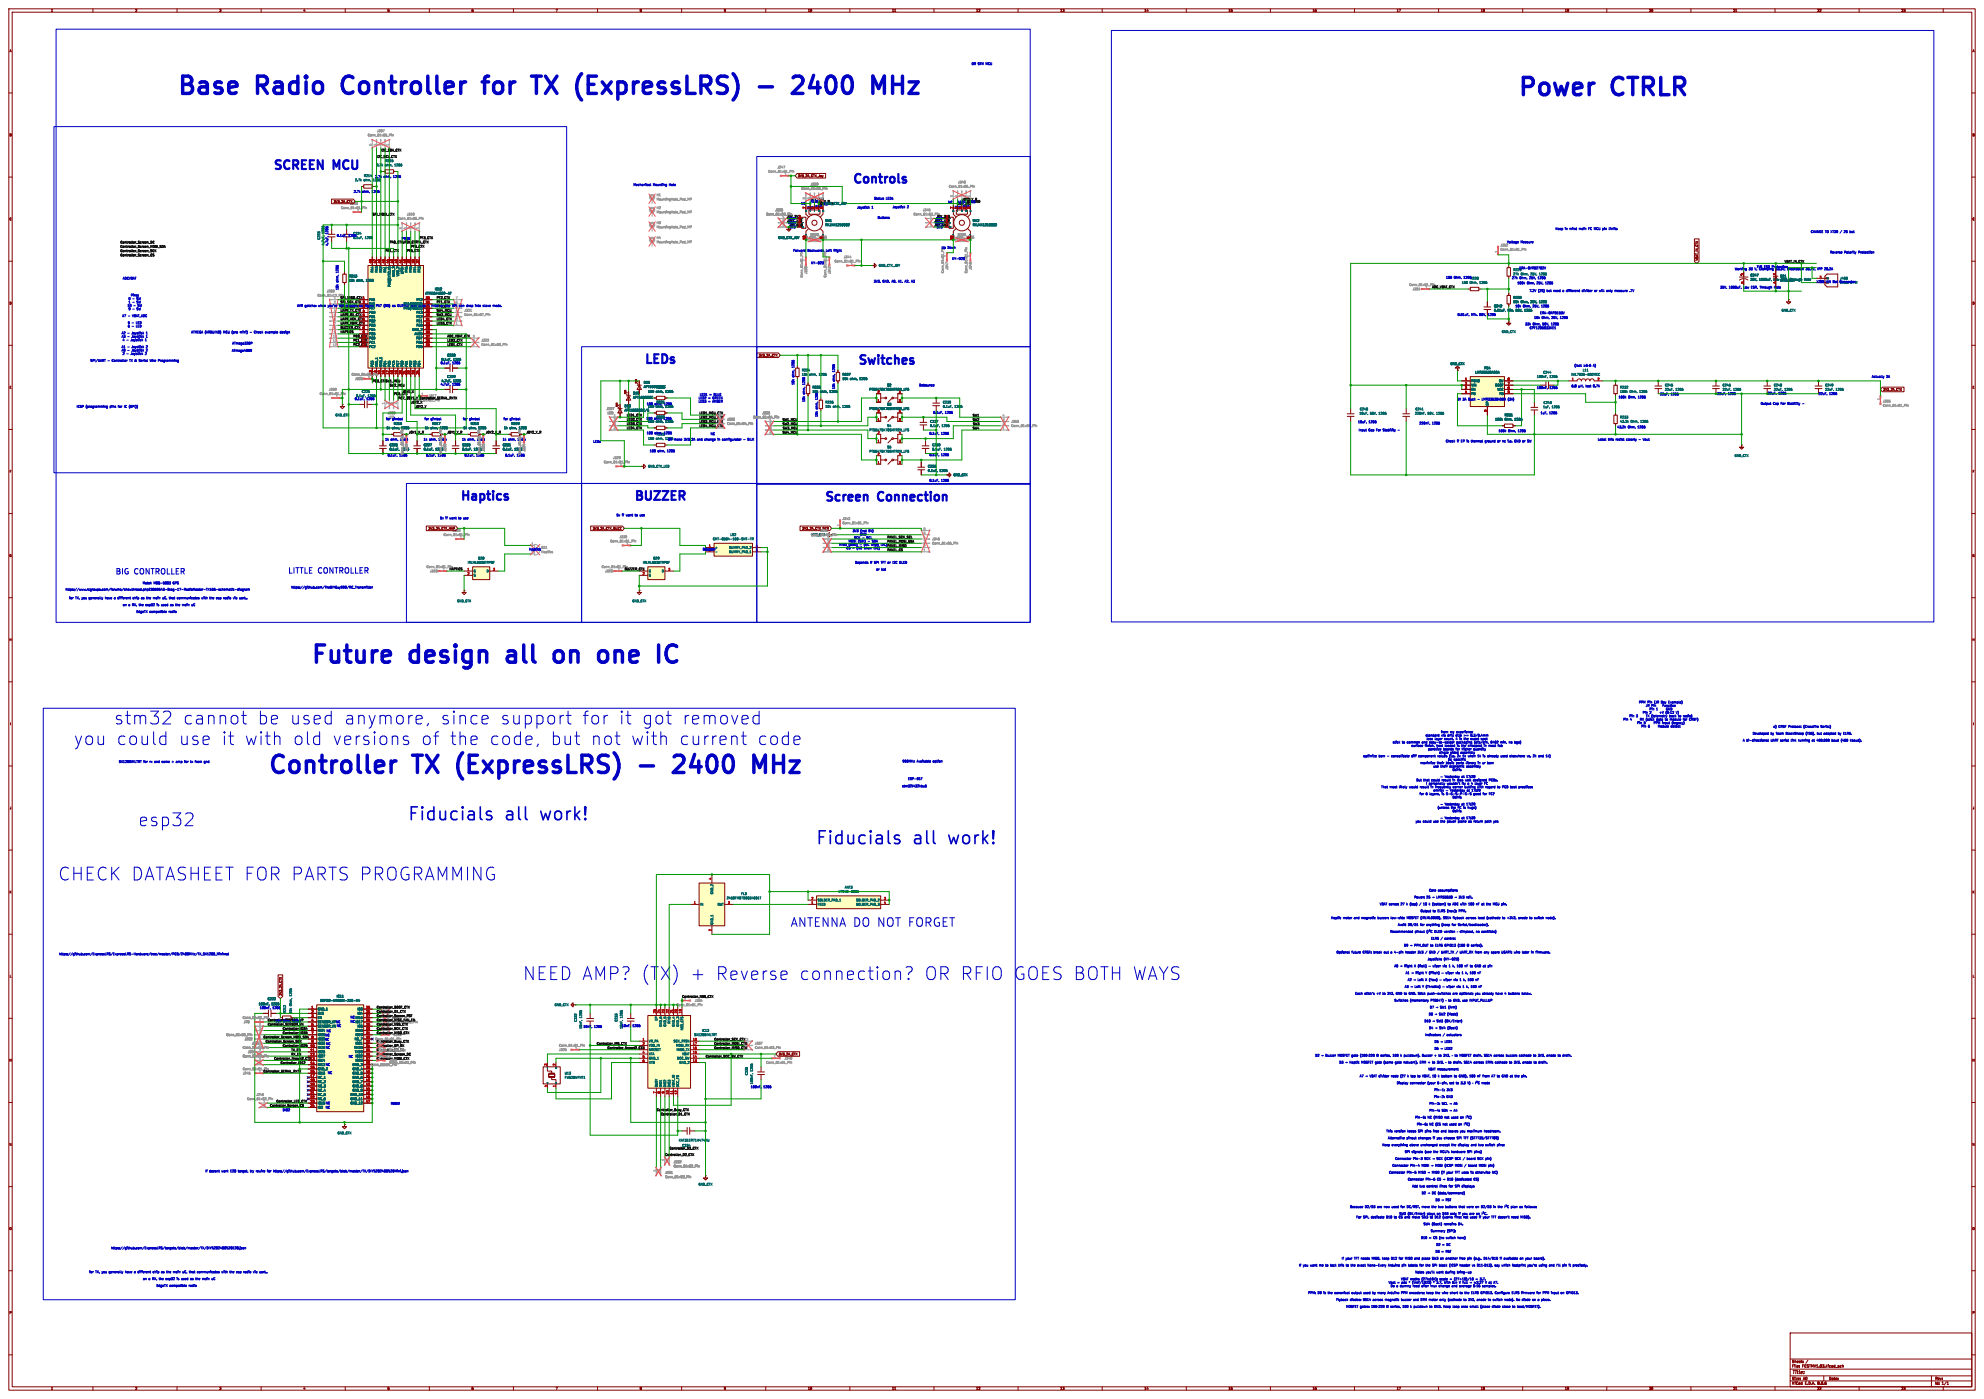
[picture p8: page 1]

3V3 https://www.youtube.com/watch?v=lv8CZSc0o-c

Base Radio Controller for TX (ExpressLRS) - 2400 MHz

35V, 1000uF, Low ESR, Through Hole

100k Ohm, 25V, 1206 NEED AMP? (TX) + Reverse connection? OR RFIO GOES BOTH WAYS

ATMEGA (ARDUINO) MCU (pro mini) - Check example design Pins: 0 - SW

2 - Joystick 2 SPI/UART - Controller TX & Serial Wire Programming

(Isat þÿ"e5 6A) 6.8 þÿµH, Isat 8.7A
L11 XAL7030-682MEC

Label this resist clearly - Vout 1uF, 1206

Check if EP is thermal ground or nc i.e. GND or SW

SCK - SCL MOSI (SDI) - SDA MISO (SDO) - (NC when I2C) CS - (NC when I2C)

Depends if SPI TFT or I2C OLED

https://www.rcgroups.com/forums/showthread.php?3869543-Blog-17-RadioMaster-TX16S-schematic-diagram

PPM Pin (JR Bay Example) JR Pin Function Pin 1 GND

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

Controller TX (ExpressLRS) - 2400 MHz

SX1280IMLTRT for rx and same + amp for tx from gnd

(unless the FC is huge) Osiris þÿ Yesterday at 17:30

you could use the power plane as return path yes

CHECK DATASHEETFOR PARTS PROGRAMMING

FEED
ANTENNA DO NOT FORGET

https://github.com/ExpressLRS/ExpressLRS-Hardware/tree/master/PCB/2400MHz/TX_SX1280_Minimal

If doesnt work E28 target, try rewire for https://github.com/ExpressLRS/targets/blob/master/TX/DIY%202400%20Mini.json

https://github.com/ExpressLRS/targets/blob/master/TX/DIY%202400%20E28.json
