CGainsWorks/emb-drone-flight-stack/hardware/rf/docs/VTX.pdf

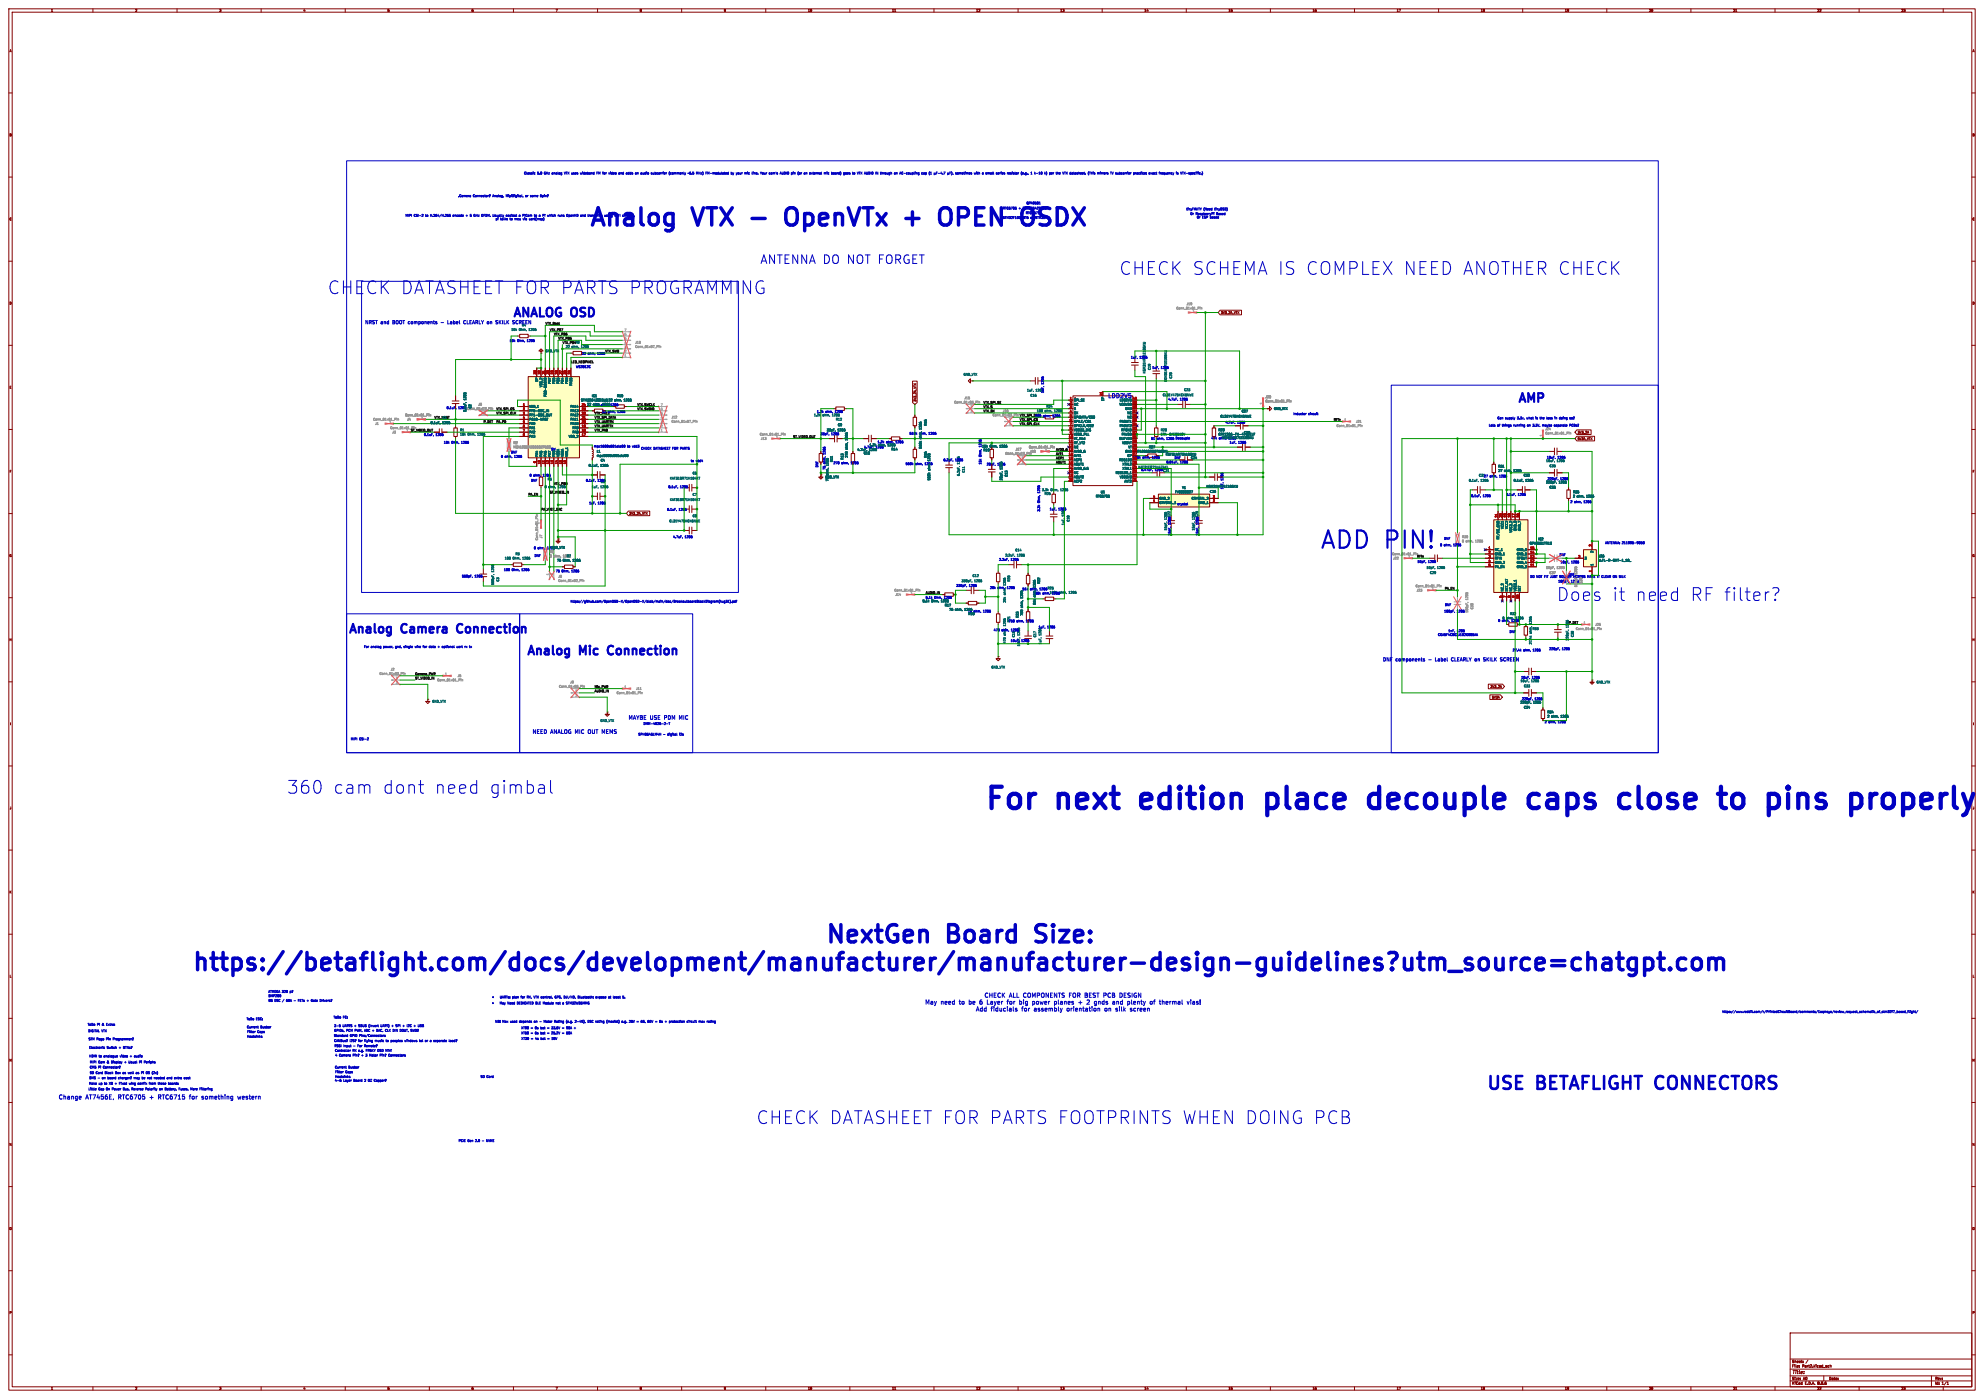
[picture p9: page 1]

750 ohm, 1206 Analog VTX - OpenVTx + OPEN OSDX
22 ohm, 1206 C3 560pF, 1206

pi talks to mcu via uart(msp)

CHECK SCHEMA IS COMPLEX NEED ANOTHER CHECK

Lots of things running on 3.3V, maybe separate PCBs? Can supply 3.3v, what is the loss in doing so?

CHECK DATASHEET FOR PARTS

75 Ohm, 1206 NEED ANALOG MIC OUT MEMS

DO NOT FIT JUST SOLDER ACROSS MAKE IT CLEAR ON SILK

https://github.com/OpenOSD-X/OpenOSD-X/blob/main/doc/BreakoutboardBlockDiagram(Aug31).pdf

CGA5F4C0G2J102G085AA MIPI CSI-2
220pF, 1206 360 cam dont need gimbal

MAYBE USE PDM MIC

https://betaflight.com/docs/development/manufacturer/manufacturer-design-guidelines?utm_source=chatgpt.com

þÿ " May Need DEDICATED BLE Module not a STM32WB5MMG

CHECK ALL COMPONENTS FOR BEST PCB DESIGN

May need to be 6 Layer for big power planes + 2 gnds and plenty of thermal vias!

https://www.reddit.com/r/PrintedCircuitBoard/comments/1aqmsye/review_request_schematic_of_stm32f7_based_flight/

ToDo Pi & Extra: MIPI Cam & Display + Usual Pi Periphs DIGITAL VTX

STM Pogo Pin Programmer?

CM5 Pi Connector? Change AT7456E, RTC6705 + RTC6715 for something western

SD Card Black Box as well as Pi OS (2x) BMS - on board charger? may be not needed and extra cost Make up to X8 + Fixed wing confix from these boards Little Cap On Power Bus, Reverse Polarity on Battery, Fuses, More Filtering

CHECK DATASHEETFOR PARTS FOOTPRINTS WHEN DOING PCB
