CGainsWorks/emb-drone-flight-stack/(commit log)

2026-08-05 Import FCSTMV1.05 flight controller design from OpenSourceDrone
    6-layer KiCad project through to fabrication outputs:
    - schematic across 7 sheets, PCB, full Gerber set rev 10.19 with drills
    - assembly position files, BOM and interactive BOM
    - controlled-impedance stackup specification
    - ESC and RF link subsystem schematics
    Adds STATUS.md recording that firmware, bring-up and flight are outstanding.
    Excludes 34 dated KiCad backups and superseded Gerber revisions.
    [FCSTMV1.05-10.19.csv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]
2026-08-05 Add STM32F405 flight controller firmware
    Implements the firmware for FCSTMV1.05 from scratch in C++20. The boards are
    unassembled, so the design is split so that all control logic is testable on a
    host with no hardware attached: maths, estimator, PID, mixer, protocol codecs
    and state machines sit above four small HAL interfaces (SpiBus, Uart,
    MotorOutput, Clock) which tests replace with mocks.
    207 tests, 183,804 assertions, 0 failures. Cross-compiles to 21,036 B flash
    (2.01%) and 5,720 B RAM (4.36%).
    Two constraints came out of reading the PCB netlist rather than assuming:
    - The IMU cannot be driven by the F405 hardware SPI1 peripheral. PA6 carries
    the ICM-42688-P's data-in and PA7 its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
    [adc.cpp, adc.hpp, attitude_estimator.cpp, battery.cpp]
2026-08-05 Add on-board diagnostics and bring-up procedure
    The remaining work all needs a physical board, and most of it was written up as
    "put a scope on it". This replaces that dependency where it can be replaced: the
    firmware now measures itself using the same microsecond counter the control loop
    runs on, and reports the numbers as plain text on the telemetry UART.
    - TimingStats: min/max/mean plus a budget-overrun count for the control loop.
    Overruns are counted separately because a healthy mean with occasional missed
    deadlines is still a broken fixed-rate loop. The mean accumulates into a
    64-bit sum rather than a running float, which stays exact over an hour at
    1 kHz.
    - benchmark_spi(): ti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
    [main.cpp, spi_benchmark.cpp, test_diagnostics.cpp, timing_stats.cpp]
2026-08-05 Correct README status and build checklist
    The README still opened with "firmware not started", which stopped being true
    two commits ago and contradicted STATUS.md. It was also the first thing anyone
    opening the repository would read.
    - Status block now states what is actually true: the firmware is written and
    passes 221 host tests, but has never executed on silicon and there are no
    measurements in the repository.
    - Build checklist updated. Only the two genuinely finished items are ticked.
    Everything needing a powered board stays unticked, with a note on what does
    exist so a partial is not mistaken for either done or untouched: the IMU
    driver is tested against a simulated device ra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
2026-08-05 Correct the pinout against the PCB netlist
    Re-extracted pad->net assignments from FCSTMV1.05.kicad_pcb and cross-checked
    against the placed-part list. Most of the existing PINOUT.md was right; these
    were not.
    Corrected:
    - USART6 does not reach the onboard GPS. PC6/PC7 carry /GPS_UARTTX and
    /GPS_UARTRX, which terminate on J129 pads. The SAM-M10Q (ANT2) drives the
    separate nets /GPS_UARTTX_2 and /GPS_UARTRX_2 onto J164/J166. The two sides
    are not joined.
    - kBuzzer was PA15. Pad 7 is PC13; PA15 carries /OSD_CS_Translated, so the
    buzzer would have toggled the OSD chip select. The constant was unused, so
    no behaviour changes. Added kLed2/kLed3 for pads 8 and 9.
    Added:
    - SPI2 (flash)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
2026-08-05 Remove .gitkeep placeholders from populated directories
    firmware/include, firmware/src/control, firmware/src/drivers,
    firmware/src/platform and firmware/test all hold real files now, so the
    placeholders that reserved them are redundant.
    Kept the four that still do a job: docs, firmware/src/config, test-results
    and tools are genuinely empty and would otherwise vanish from the tree.
2026-10-16 Fix inverted pitch column in the quad-X mixer
    With motor 0 front-right and positive pitch meaning nose up (as mixer.hpp
    documents), a nose-up moment needs more thrust at the front. The table
    raised the rear motors instead, so the pitch loop had positive feedback.
    The software-in-the-loop simulator added next diverged in pitch within
    0.3 s of release, which is how this was found. The two tests that
    encoded the wrong physics now assert the right one.
    [mixer.cpp, test_flight_controller.cpp, test_mixer.cpp]
2026-10-16 Add software-in-the-loop quadrotor simulator and PID tuner
    firmware/sim/sil closes the unmodified FlightController, IMU driver,
    PID, mixer and arming logic around a rigid-body quad-X with first-order
    motor lag, output latency, sensor noise and a constant disturbance
    torque, through the existing HAL mocks. Plant parameters are assumed,
    not measured. fc_sil runs five step scenarios and writes CSV and a
    metrics JSON; every output is labelled simulated.
    tools/pid_tuner.py runs, tunes (coordinate descent, scored on a nominal
    and a slower, heavier plant), checks and plots those results.
    [fc_sil_main.cpp, quad_plant.cpp, quad_plant.hpp, sil_harness.cpp, sil_harness.hpp]
2026-10-16 Adopt simulation-tuned attitude gains and gate CI on them
    Gains come from tools/pid_tuner.py started from the old placeholders
    (tools/placeholder_gains.json), rounded, with yaw P eased by hand for
    overshoot margin on the perturbed plant. They are simulated only and
    have never driven a motor.
    test_sil checks the plant's sign conventions independently of the
    mixer and asserts every standard step settles within its overshoot and
    settling limits on both plants. It also pins the angle-mode estimator
    drift under a held tilt. test-results/sil holds the simulated step
    responses, metrics, plots and tuning record.
    [pitch_angle_step.csv, pitch_rate_step.csv, roll_angle_step.csv, roll_rate_step.csv, yaw_rate_step.csv]
2026-10-16 Add barometer, magnetometer and GPS drivers with simulated devices
    An I2cBus HAL interface, plus drivers written against the HAL:
    - BMP390 (IC9, I2C1 at 0x77): reset, identify, NVM trimming data,
    configuration with read-back, datasheet float compensation, ISA
    altitude. Init fails cleanly while CSB is unstrapped (R128 not fitted).
    - MMC5983MA (IC10): 18-bit single-shot reads with a polling timeout and
    SET/RESET bridge-offset removal, plus tilt-compensated heading.
    - UBX NAV-PVT parser and GpsReceiver for the SAM-M10Q.
    sim/sensors holds host-side device models: a register-level BMP390 with
    synthetic trimming coefficients that inverts the compensation, an
    MMC5983MA whose sensed field fli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
2026-10-16 Run the real firmware image on Renode with a simulated IMU
    fcstmv105.repl extends Renode's stock STM32F4 platform with the F405's
    FPU core type, CCM RAM and an 84 MHz TIM2 clock. Icm42688BitBang.cs is a
    GPIO-level ICM-42688-P model: it decodes the firmware's own bit-banged
    SPI mode 3 waveform on PA4..PA7 and drives SDO back, so the unmodified
    fc_firmware.elf brings up its IMU, calibrates the gyro and runs its
    1 kHz control loop on the emulated MCU.
    fc_firmware.robot asserts the UART5 boot text, that the IMU saw one
    soft reset and no protocol errors, that the control loop makes at least
    5000 burst reads, that the estimator's CRSF attitude telemetry follows
    a simulated 10 deg tilt, and that a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
2026-10-16 CI: pinned Arm GNU Toolchain, Renode run and SIL gate
    The cross build now uses the Arm GNU Toolchain 13.3.rel1, checksummed
    and cached, instead of the distro package. The image job then runs the
    Renode suite on Renode 1.16.1 (checksummed, cached). The host job runs
    the simulated step responses, gates them against their limits on the
    nominal and a perturbed plant, and checks them against the committed
    copy within a tolerance. Superseded runs are cancelled and every job
    has a timeout. Actions are pinned by release tag.
2026-10-16 Bring README, STATUS and the firmware README up to date
    README: drops the brief scaffolding (intended structure, starter
    prompt, definition of done, notes) and the CV wording; adds the
    verification table, the simulated step-response results and the two
    findings from simulation. Every figure is labelled host test, simulated
    or emulated.
    firmware/README.md: 259 tests rather than 188, the platform layer is no
    longer drawn as unwritten, and new sections cover the SIL simulator,
    the Renode run and the sensor drivers.
    STATUS.md: Complete, In progress, Not started and Limitations as of
    16 October 2026, and a one-line summary that matches the rest.
